fanfan328/assembly_linefollower/README.md

# assembly_linefollower
Line Followers with Assembly Lang
