fanfan328/assembly_linefollower/AKRILIK/akrilik-lt2.pdf

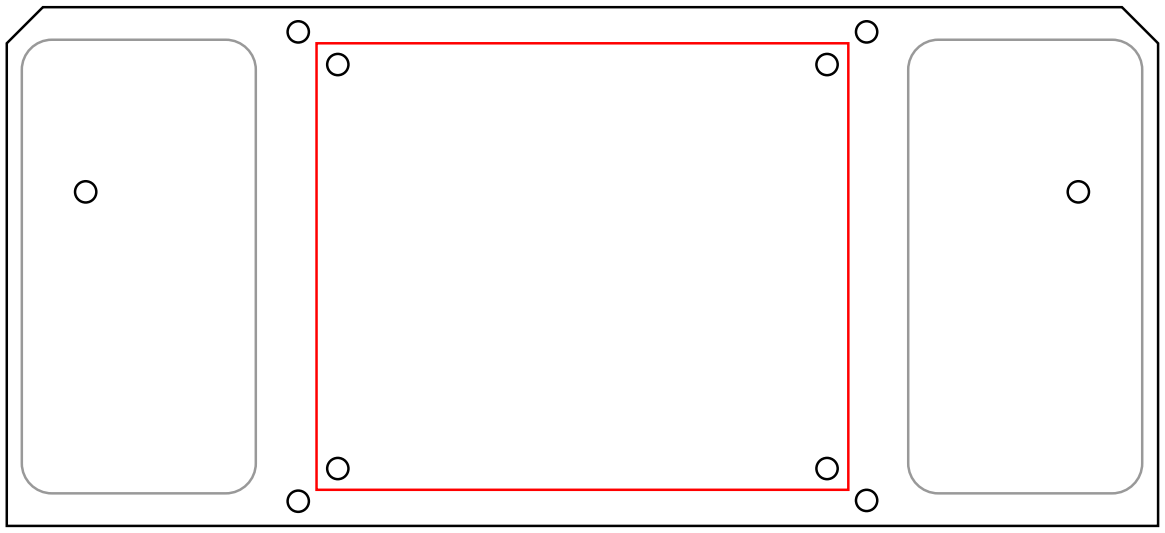
[picture p8: figure]
