fanfan328/assembly_linefollower/AKRILIK/akrilik-lt1.jpg

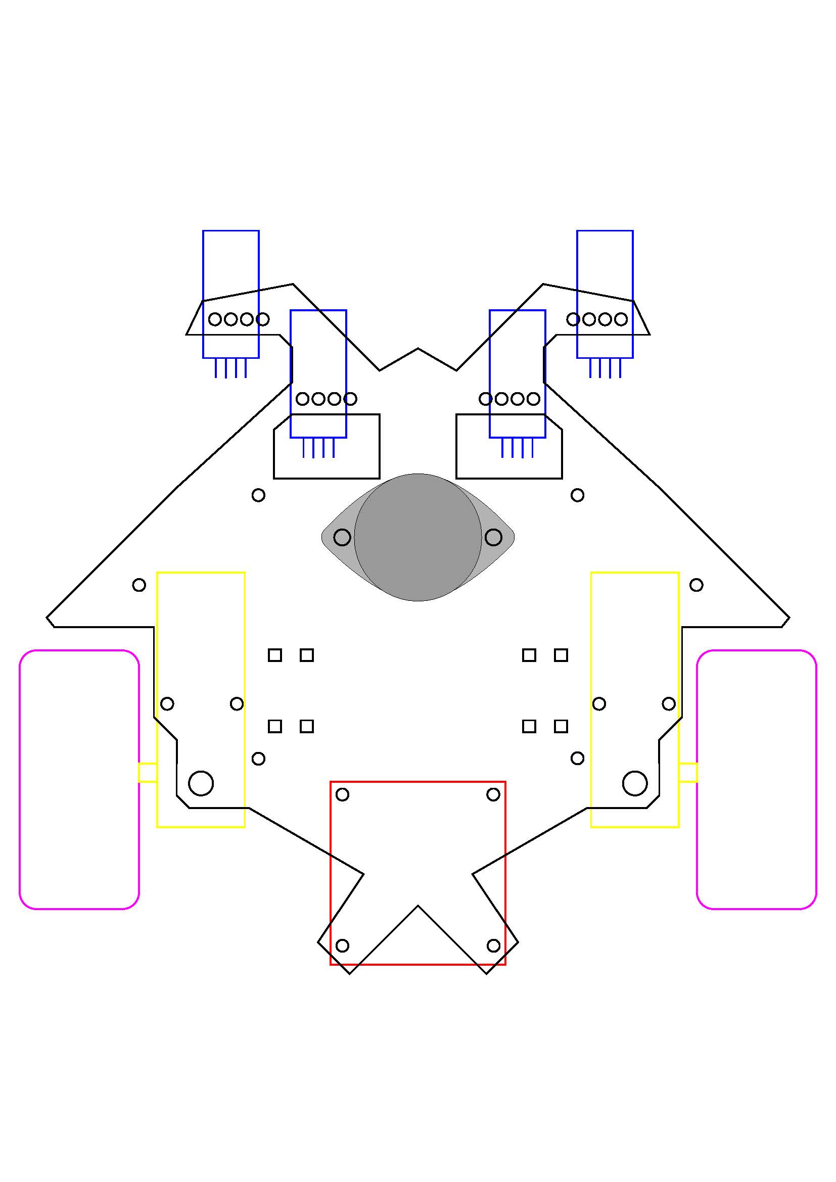
AKRILIK/akrilik-lt1.jpg
