fanfan328/assembly_linefollower/AKRILIK/akrilik-lt2.jpg

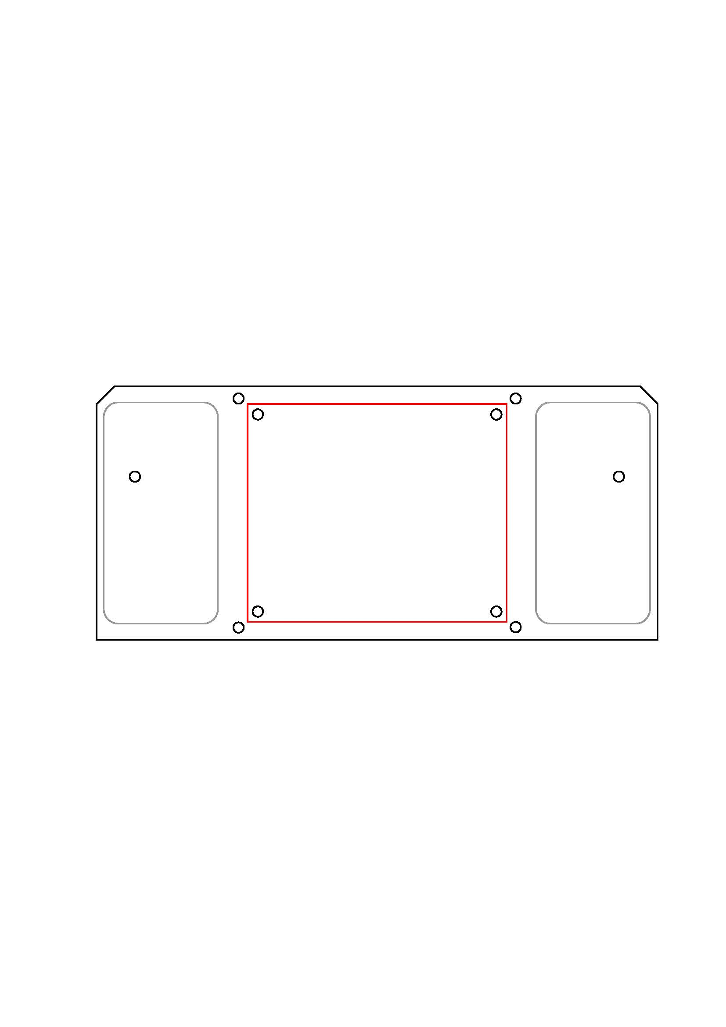
AKRILIK/akrilik-lt2.jpg
