fanfan328/assembly_linefollower/AKRILIK/akrilik-lt2-print.pdf

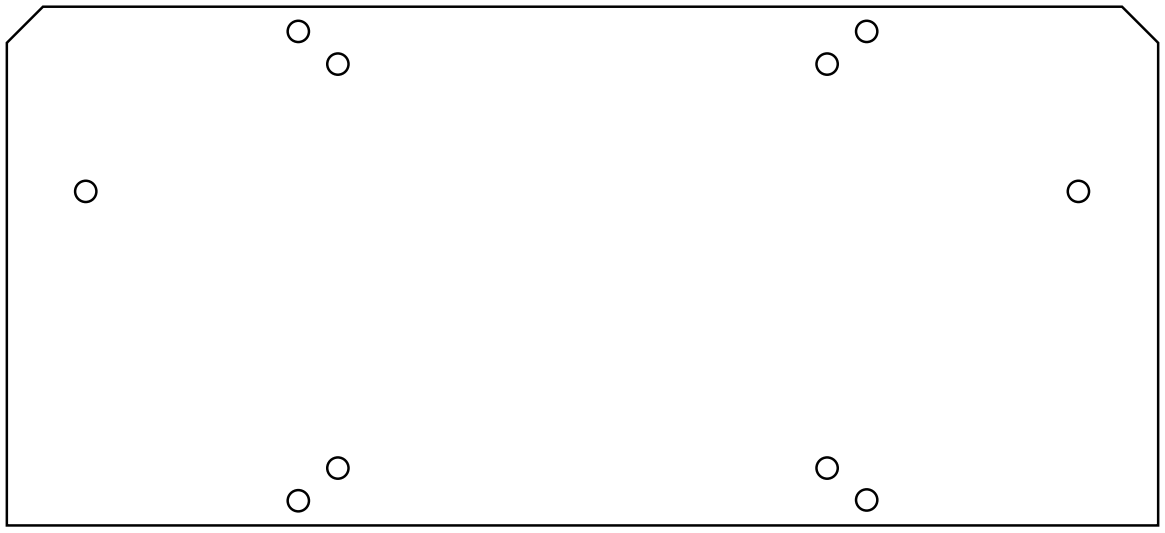
[picture p14: figure]
