fanfan328/assembly_linefollower/AKRILIK/akrilik-lt1-print.pdf

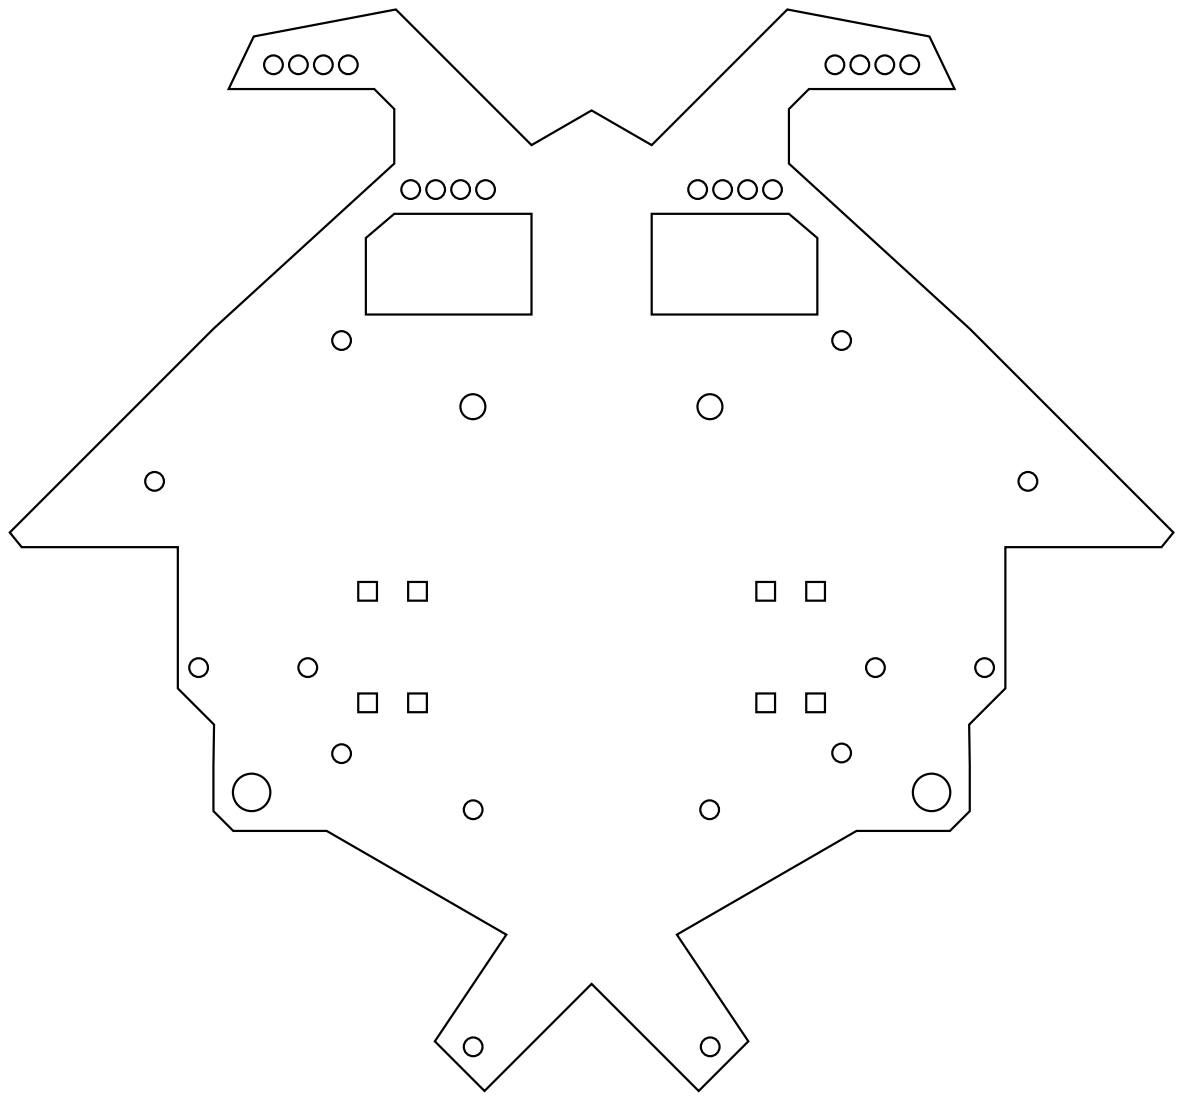
[picture p11: page 1]
