fanfan328/assembly_linefollower/route.pdf

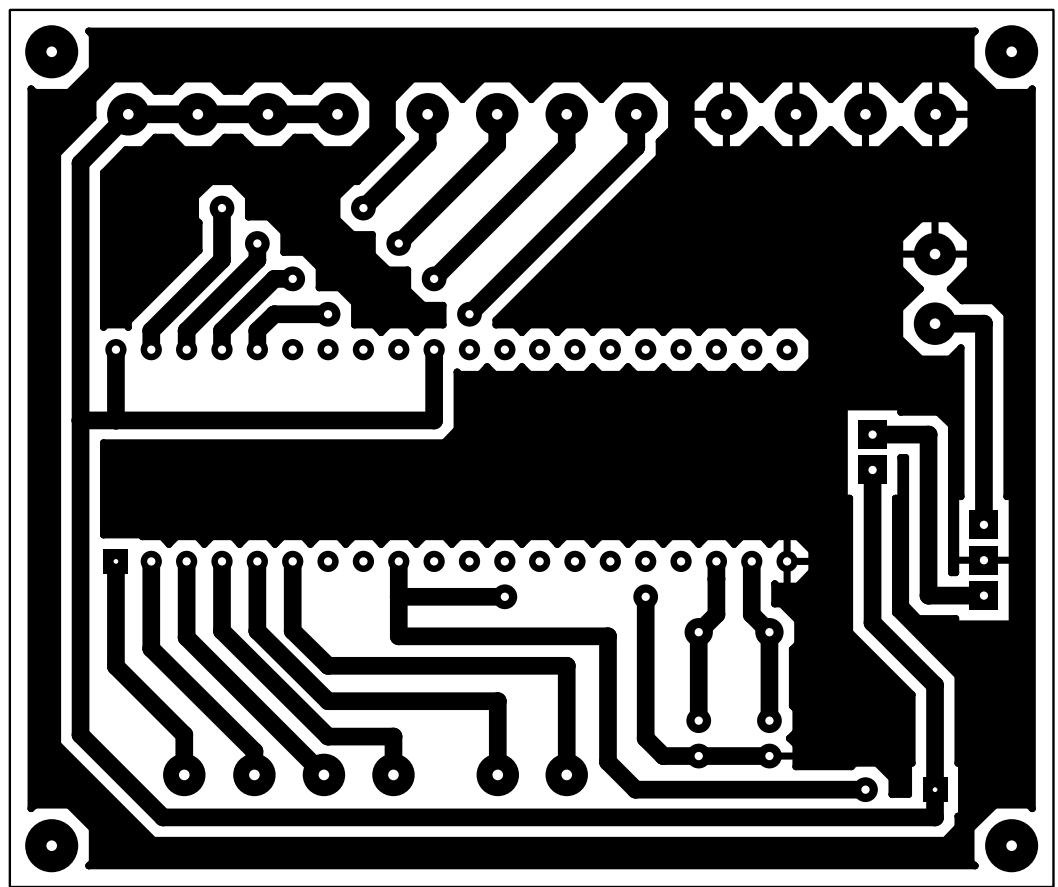
[picture p12: page 1]
