fanfan328/assembly_linefollower/AKRILIK/akrilik-lt1.pdf

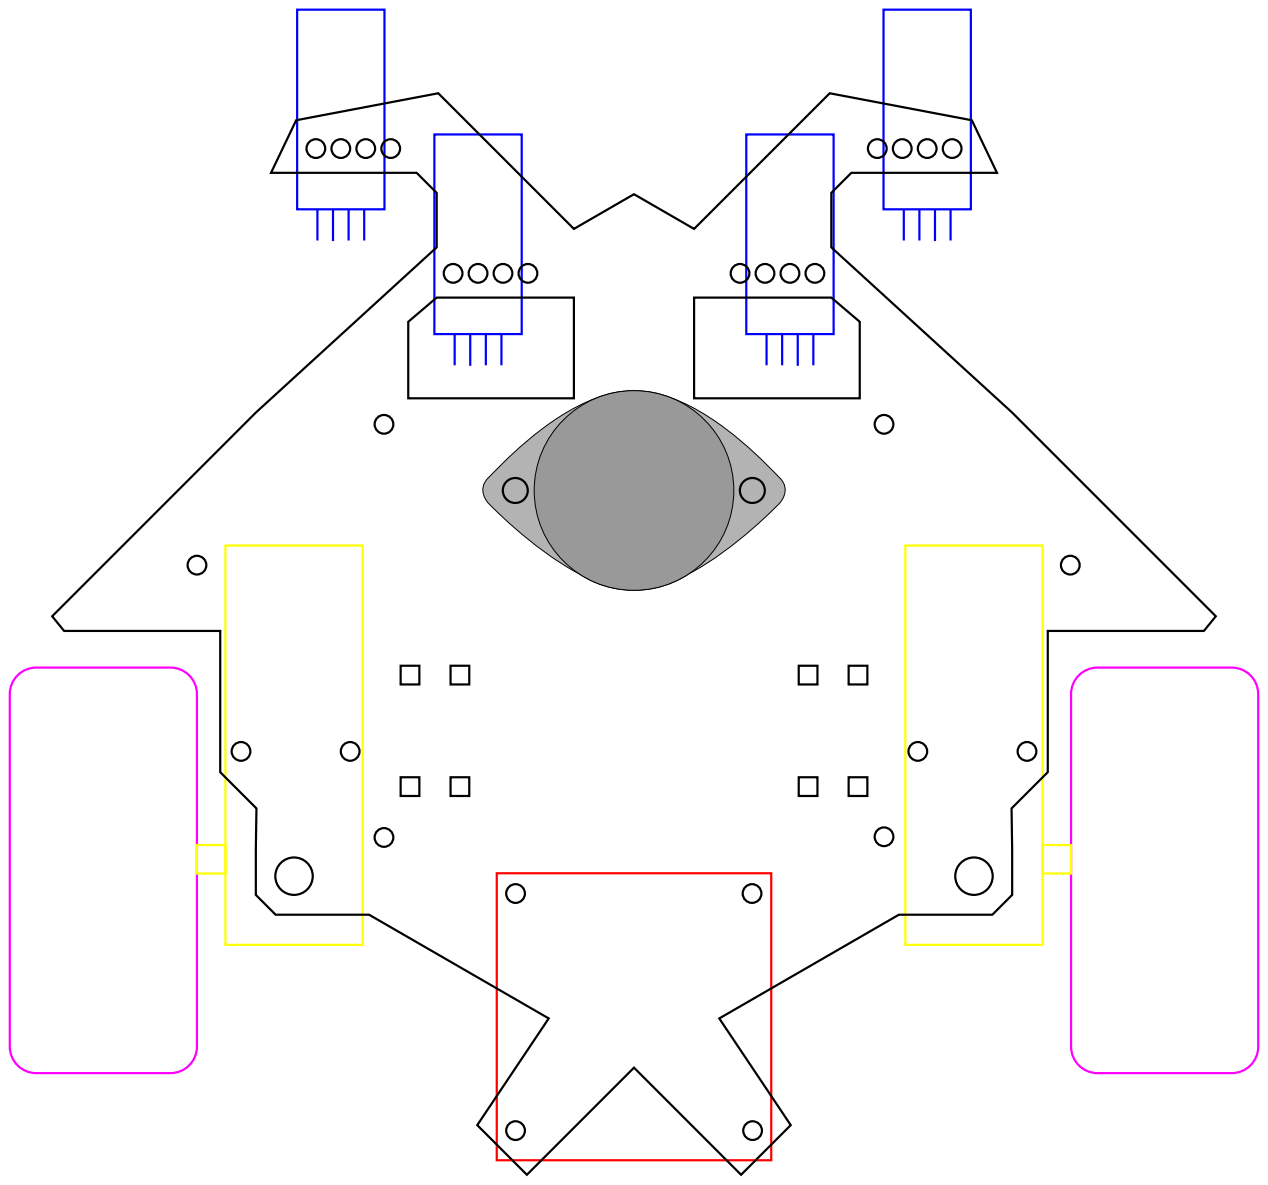
[picture p13: page 1]
