fanfan328/assembly_linefollower/(list of files, drawings)

Other design files:
PCB.pdsprj
